D-KG5/LPEDT_revA1_bikeit/LPEDT_revA1_bikeit.pdf

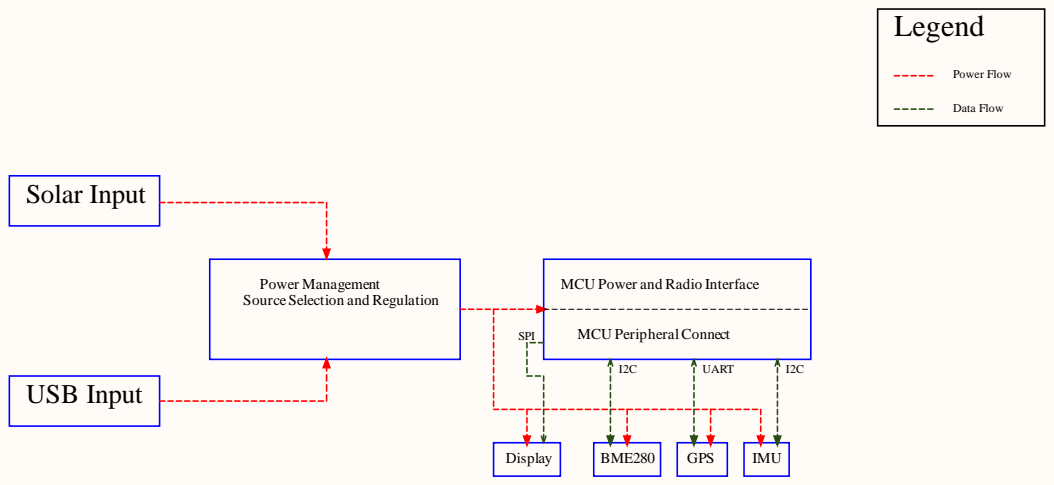
[picture p1: page 1]

MCU Power and Radio Interface

Bike It System Architecture

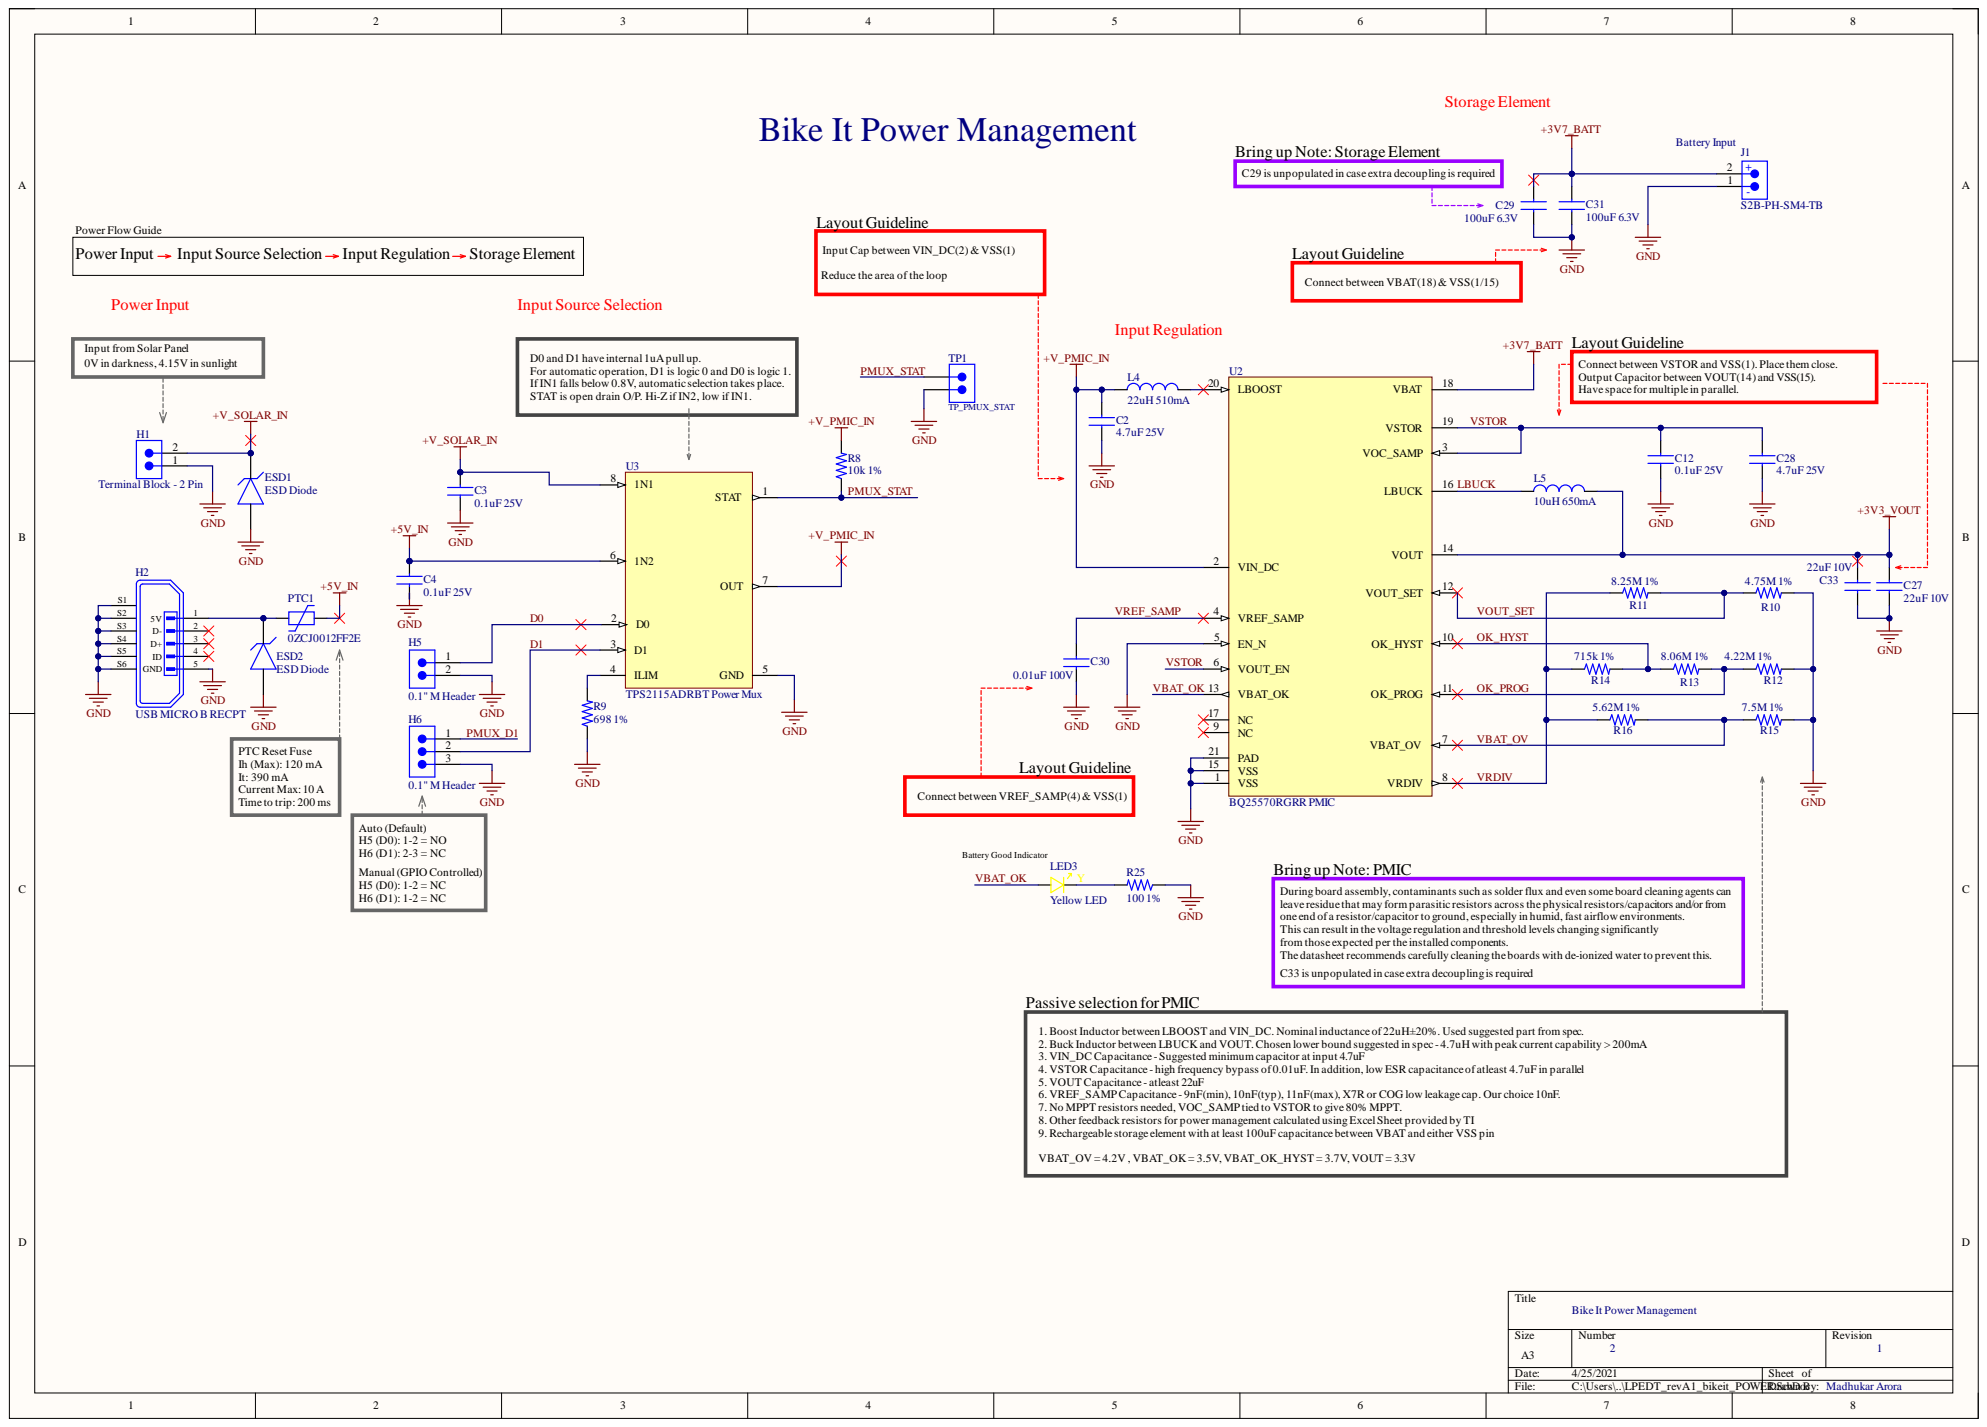
[picture p2: page 2]

Bike It Power Management

Bring up Note: Storage Element

C29 is unpopulated in case extra decoupling isrequired

Input Cap between VIN_DC(2)& VSS(1)

Reduce the area of the loop

Connect between VBAT(18)& VSS(1/15)

Input from Solar Panel

For automatic operation, D1 is logic 0 and D0 is logic 1.
IfIN1 falls below 0.8V, automatic selection takes place.
STAT is open drain O/P. Hi-Z if IN2, low if IN1.

Connect between VSTOR and VSS(1). Place them close.
Output Capacitor between VOUT(14) and VSS(15).
Have space for multiple in parallel.

OK_PROG | R14 R13

PTC Reset Fuse
Ih (Max): 120 mA
Current Max: 10 A
Time to trip: 200 ms

Bring up Note: PMIC

During board assembly, contaminantssuch assolder flux and even some board cleaning agents can
leave residue that may form parasitic resistors acrossthe physicalresistors/capacitors and/or from
one end of a resistor/capacitor to ground, especially in humid, fast airflow environments.
This can result in the voltage regulation and threshold levels changing significantly
from those expected per the installed components.
The datasheet recommends carefully cleaning the boards with de-ionized water to prevent this.
C33 is unpopulated in case extra decoupling isrequired

Passive selection for PMIC

1. Boost Inductor between LBOOST and VIN_DC. Nominal inductance of 22uH±20%. Used suggested part from spec.
2. Buck Inductor between LBUCK and VOUT. Chosen lower bound suggested in spec - 4.7uH with peak current capability > 200mA
3. VIN_DC Capacitance - Suggested minimum capacitor at input 4.7uF
4. VSTOR Capacitance - high frequency bypass of 0.01uF. In addition, low ESR capacitance of atleast 4.7uF in parallel
5. VOUT Capacitance - atleast 22uF
6. VREF_SAMPCapacitance - 9nF(min), 10nF(typ), 11nF(max), X7R or COG low leakage cap. Our choice 10nF.
7. No MPPT resistors needed, VOC_SAMP tied to VSTOR to give 80% MPPT.
8. Other feedback resistorsfor power management calculated usingExcel Sheet provided by TI
9. Rechargeable storage element with at least 100uF capacitance between VBAT and either VSS pin

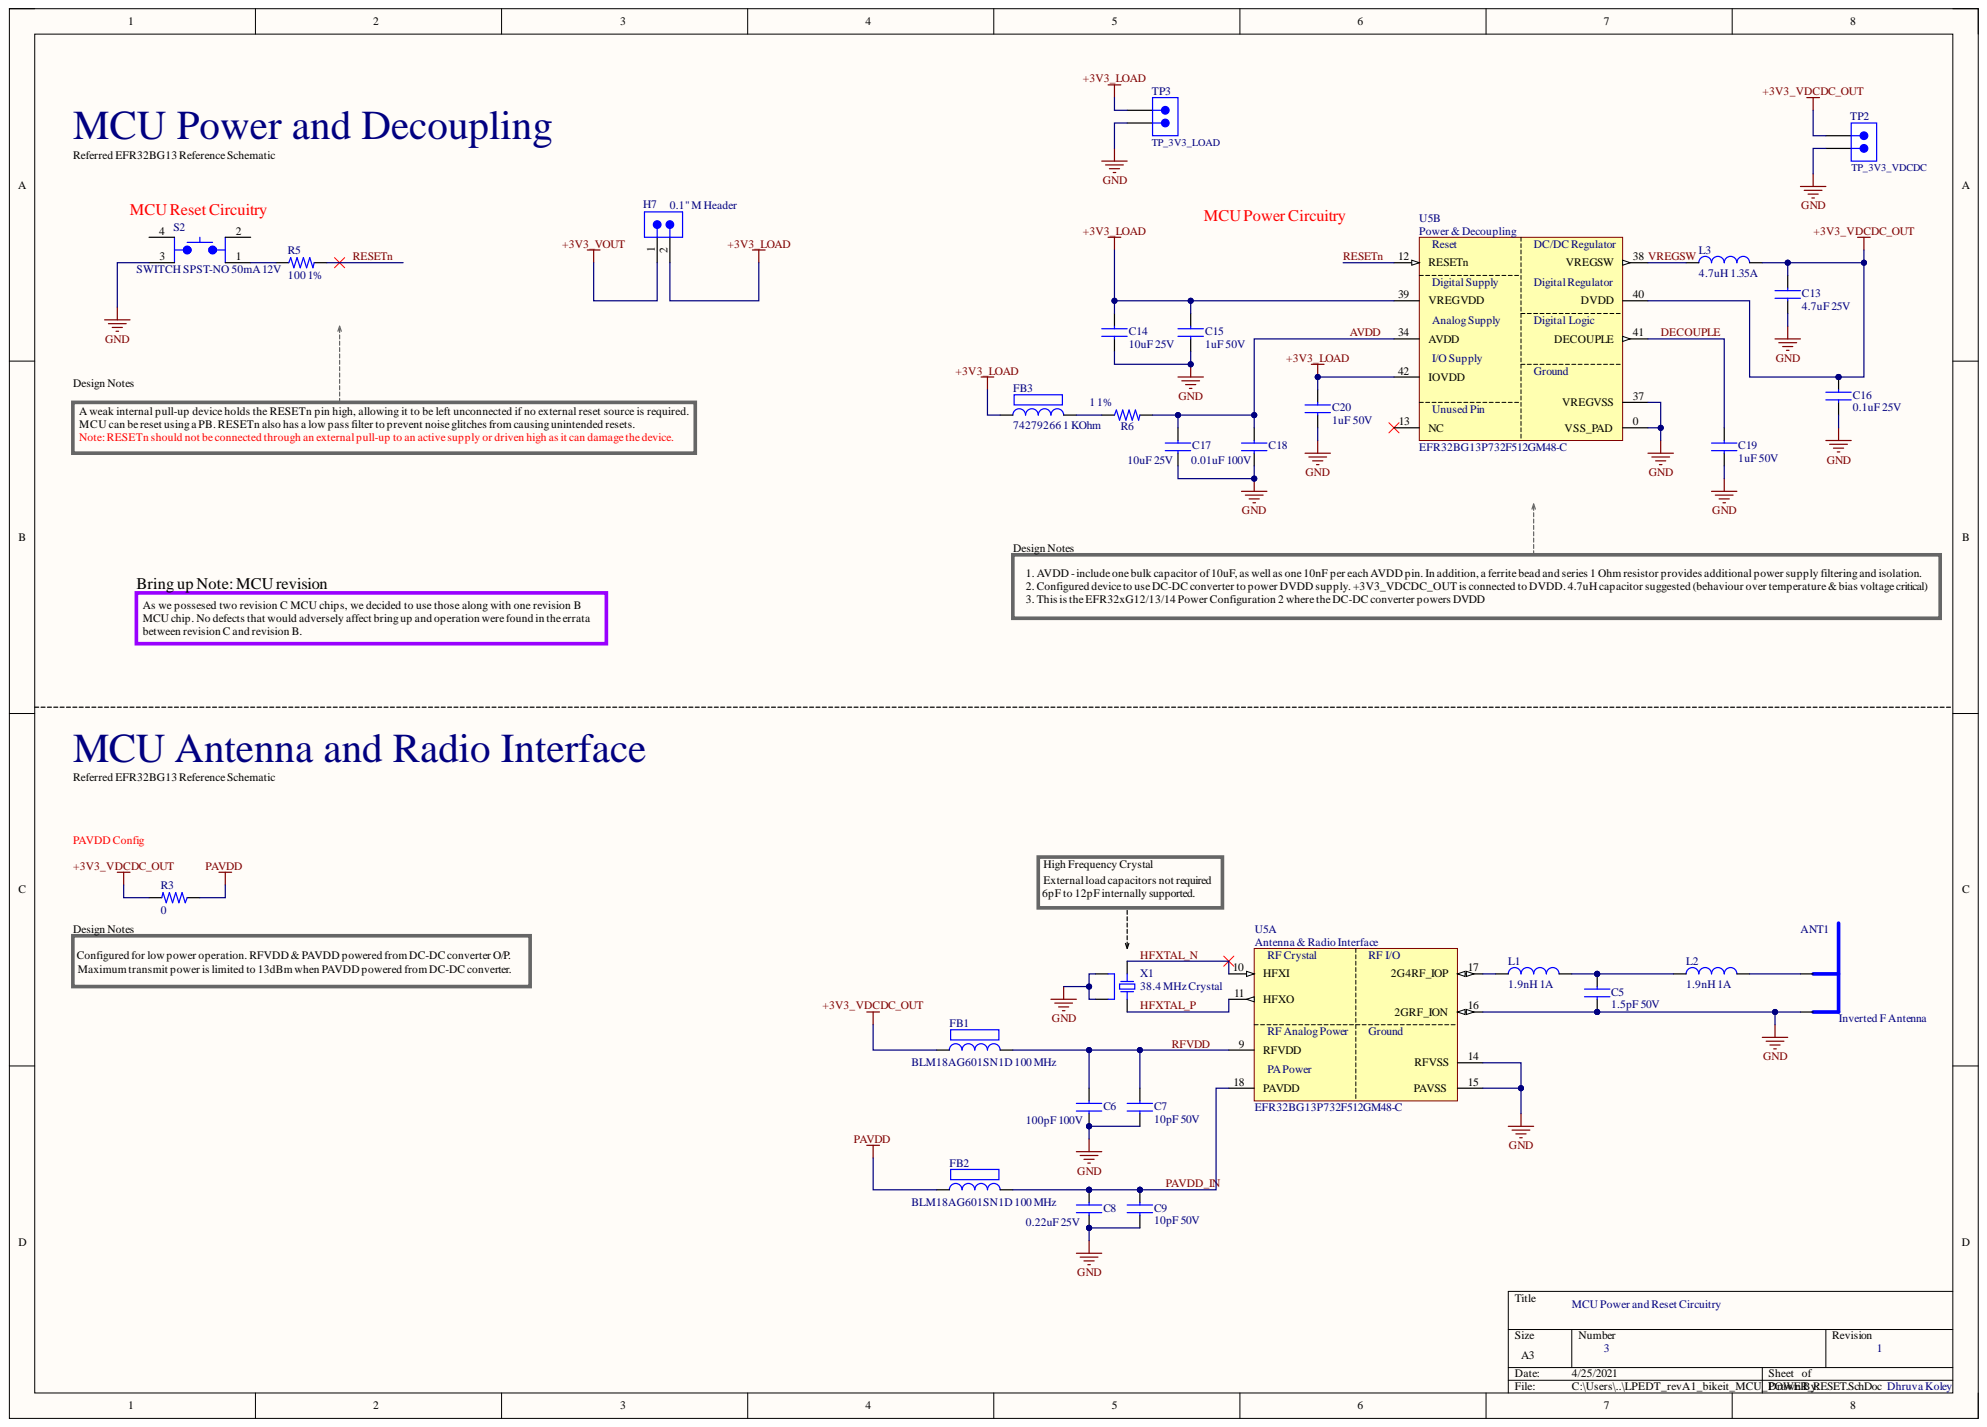
[picture p3: page 3]

MCU Power and Decoupling

A weak internal pull-up device holds the RESETn pin high, allowing it to be left unconnected if no external reset source is required.
MCU can be reset using a PB. RESETn also has a low passfilter to prevent noise glitchesfrom causing unintended resets.
Note:RESETn should not be connected through an external pull-up to an active supply or driven high asit can damage the device.

1. AVDD -include one bulk capacitor of 10uF, as well as one 10nF per each AVDD pin. In addition, a ferrite bead and series 1 Ohm resistor provides additional powersupply filtering and isolation.

3. ThisistheEFR32xG12/13/14 Power Configuration 2 where theDC-DC converter powers DVDD

As we possesed two revision C MCU chips, we decided to use those along with one revision B
MCU chip. No defectsthat would adversely affect bring up and operation were found in the errata
between revision C and revision B.

MCU Antenna and Radio Interface Referred EFR32BG13 ReferenceSchematic

High Frequency Crystal
External load capacitors not required
6pF to 12pF internally supported.

Configured for low power operation. RFVDD & PAVDD powered from DC-DC converter O/P.
Maximum transmit power islimited to 13dBm when PAVDD powered from DC-DC converter.

MCU Power and Reset Circuitry

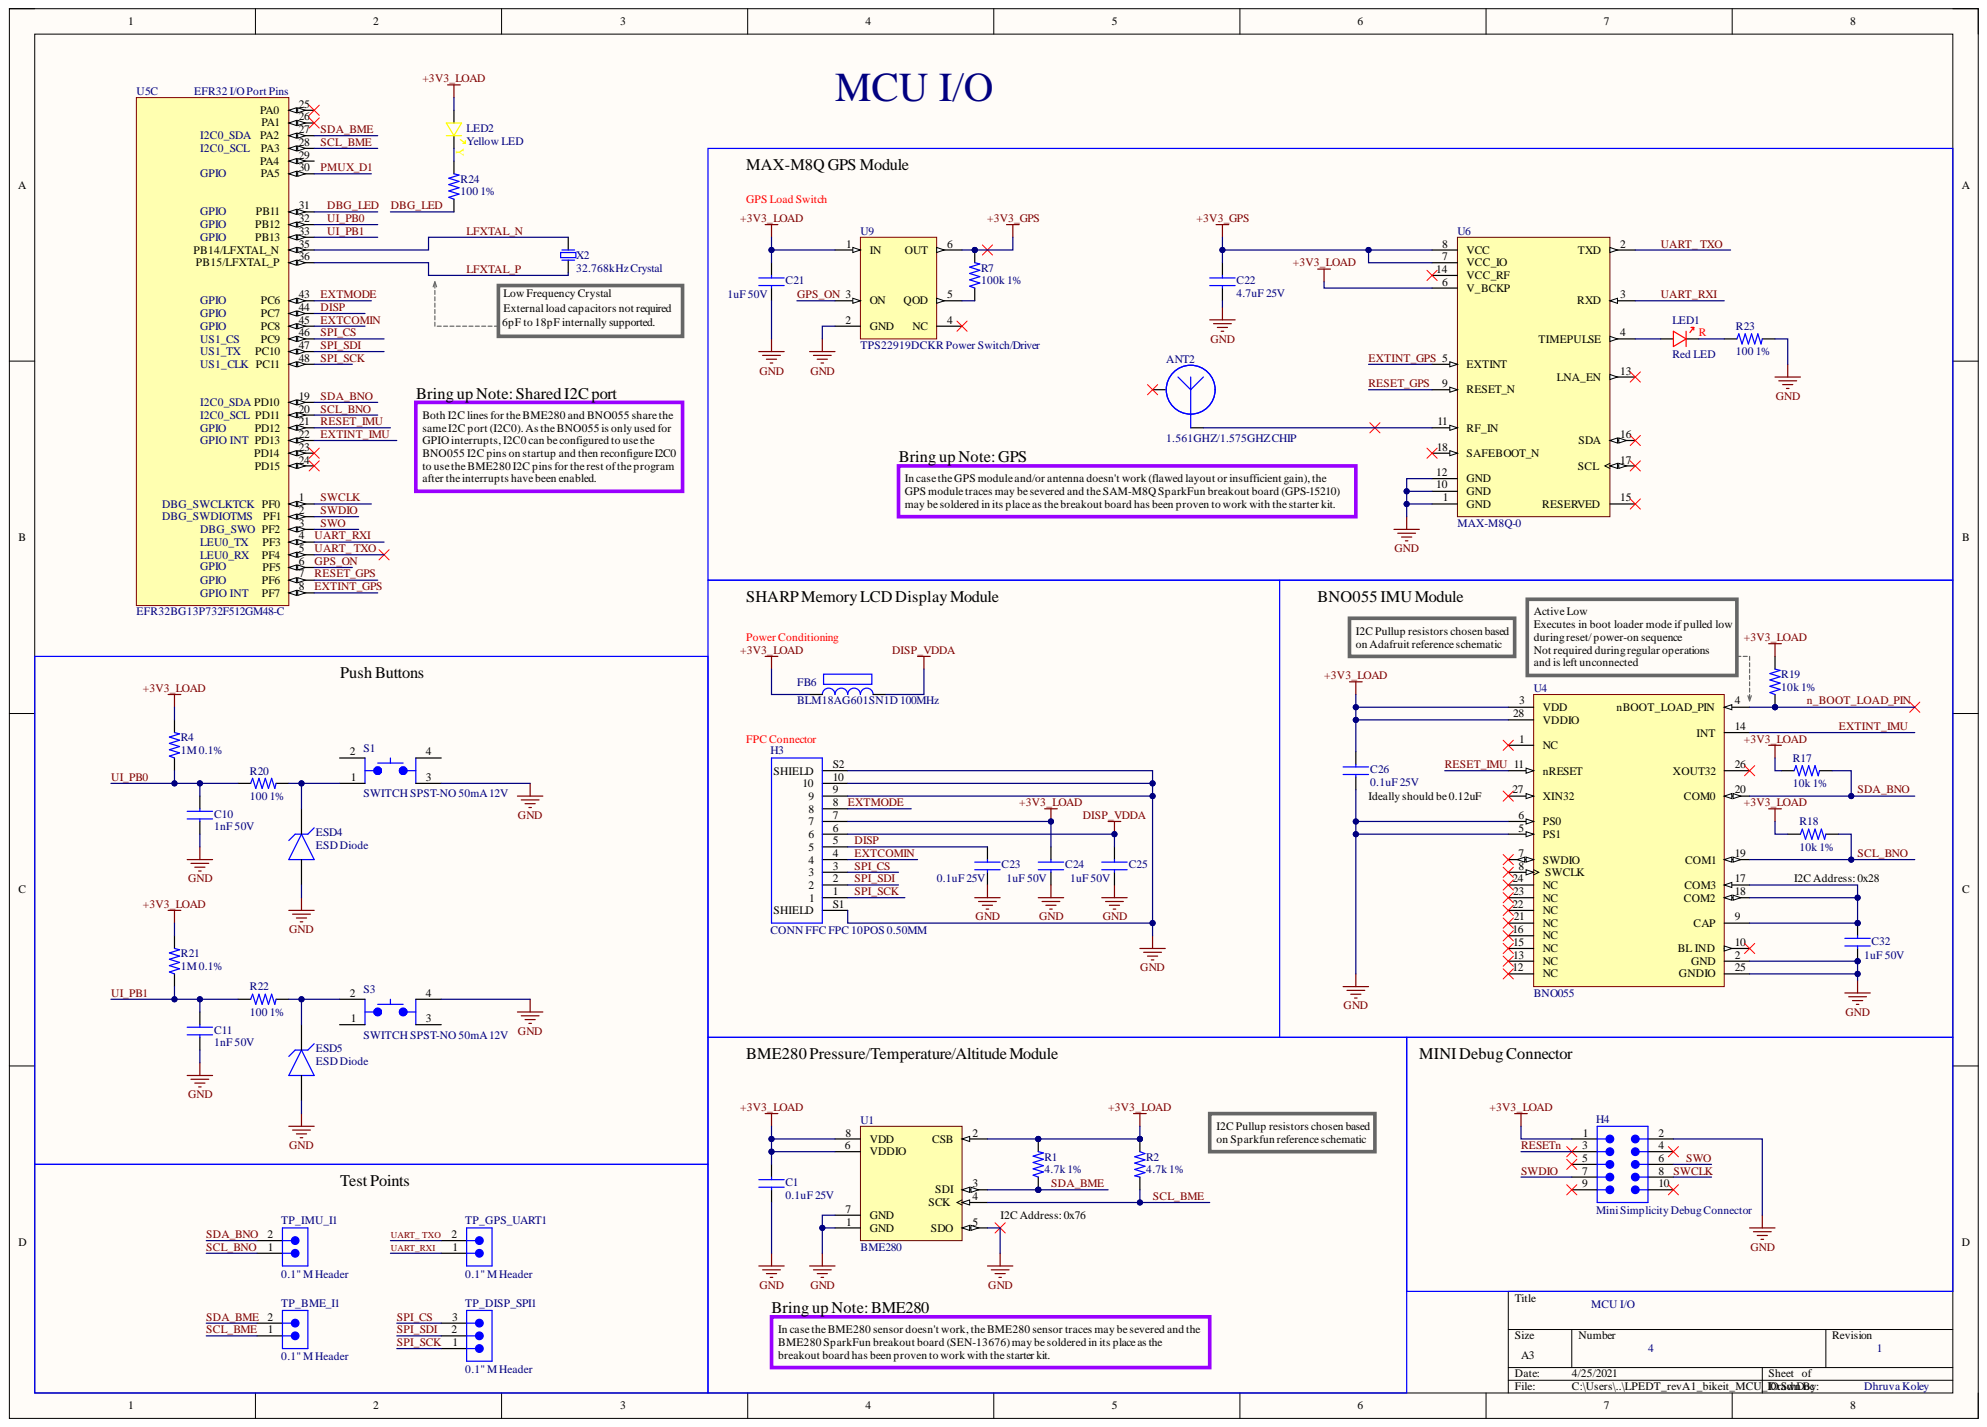
[picture p4: page 4]

Low Frequency Crystal
External load capacitors not required

Bring up Note: Shared I2C port

Both I2C linesfor theBME280 and BNO055 share the
same I2C port (I2C0). AstheBNO055 is only used for
GPIO interrupts, I2C0 can be configured to use the
BNO055 I2C pins on startup and then reconfigure I2C0
to use theBME280 I2C pinsfor the rest ofthe program
after the interrupts have been enabled.

Bring up Note: GPS

In case theGPS module and/or antenna doesn't work (flawed layout or insufficient gain), the
GPS module traces may be severed and theSAM-M8Q SparkFun breakout board (GPS-15210)
may be soldered in its place asthe breakout board has been proven to work with the starter kit.

SHARPMemory LCD Display Module

Active Low
Executes in boot loader mode if pulled low
during reset/ power-on sequence
Not required during regular operations
and isleft unconnected

I2C Pullup resistors chosen based
on Adafruit reference schematic

SWITCH SPST-NO 50mA12V GND

BME280 Pressure/Temperature/Altitude Module

on Sparkfun reference schematic

In case theBME280 sensor doesn't work, theBME280 sensor traces may be severed and the
BME280 SparkFun breakout board (SEN-13676)may be soldered in its place asthe
breakout board has been proven to work with the starter kit.

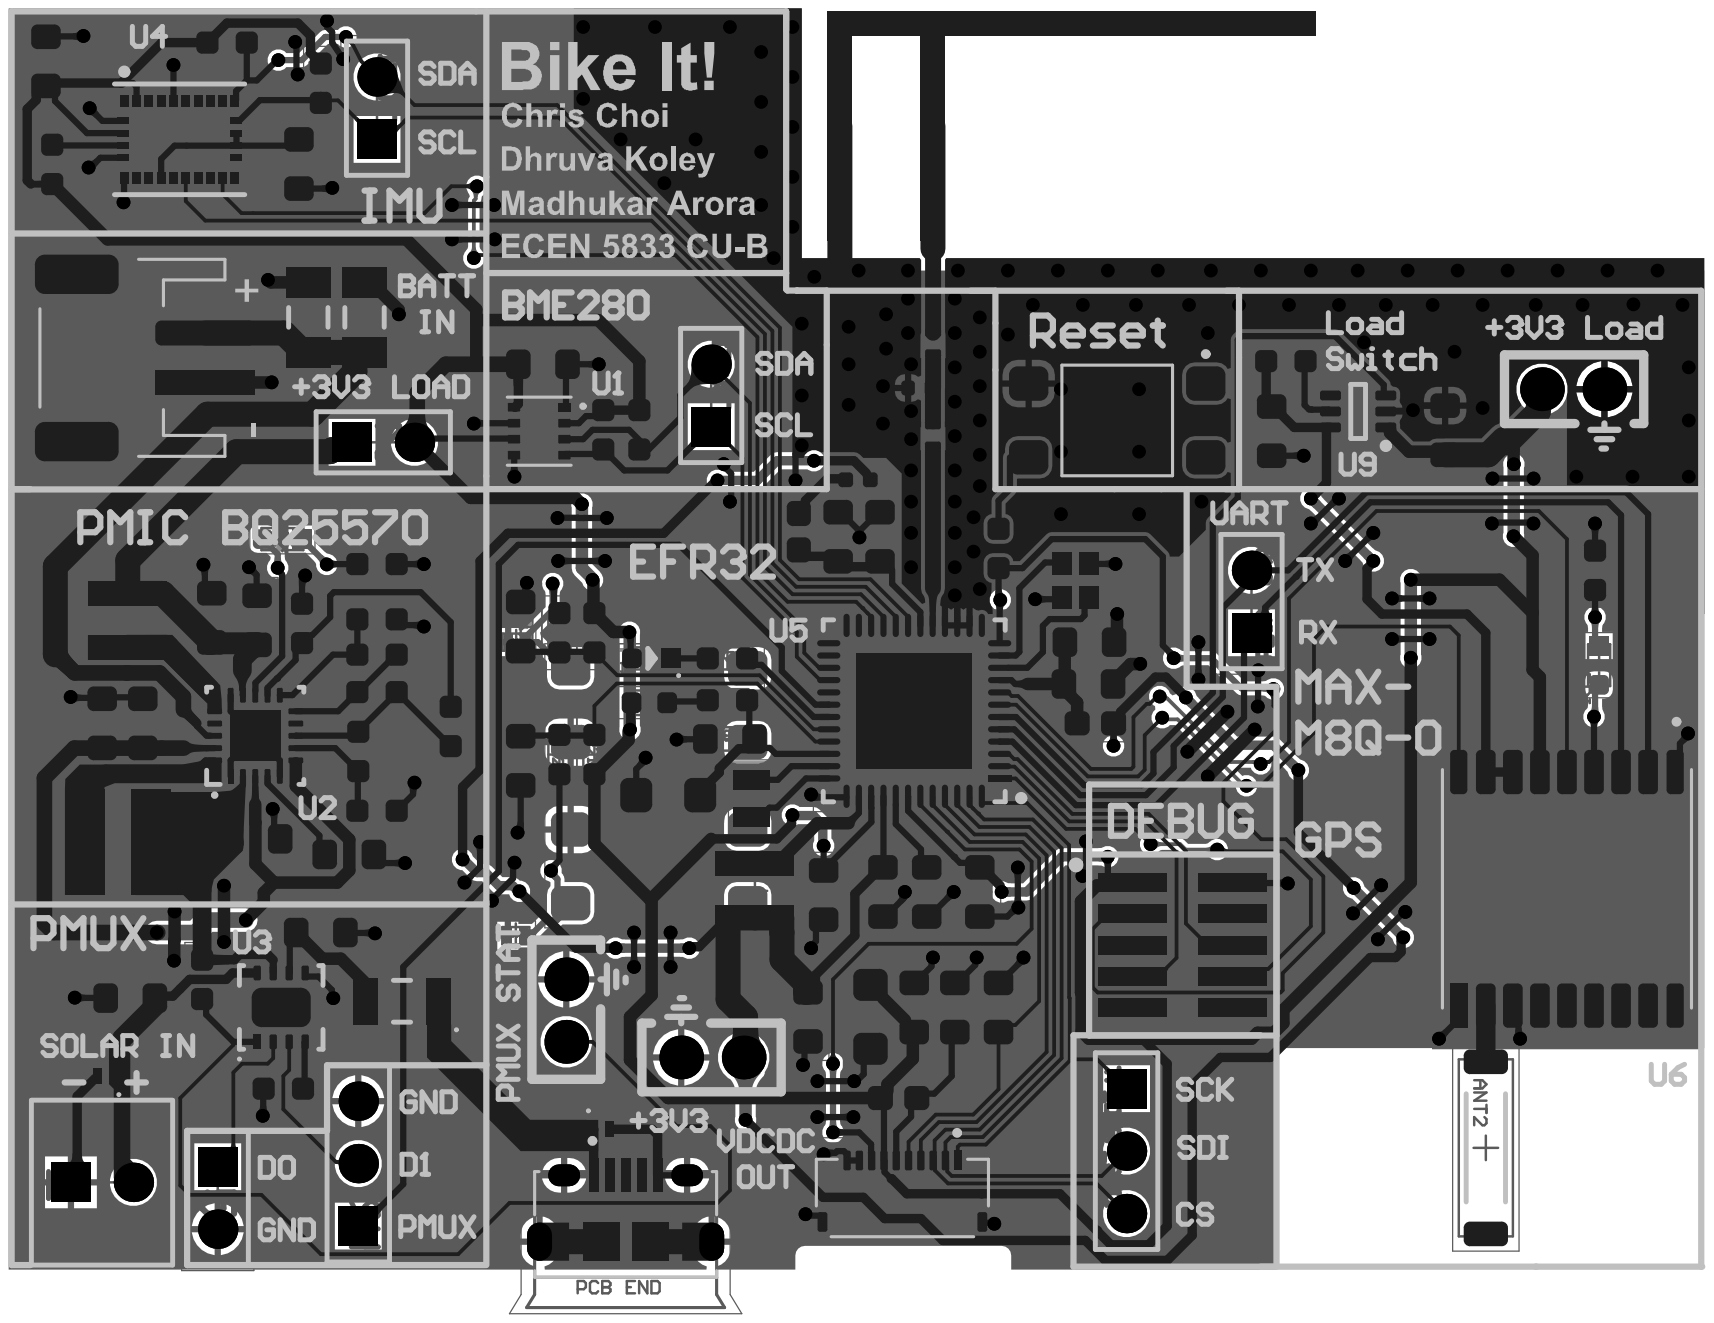
[picture p5: page 5]
