D-KG5/LPEDT_revA1_bikeit/(list of files, drawings)

Other design files:
LPEDT_revA1_BikeIt.PcbDoc
LPEDT_revA1_bikeit.PcbLib
LPEDT_revA1_bikeit.PrjPcb
LPEDT_revA1_bikeit.SchLib
LPEDT_revA1_bikeit_MCU_IO.SchDoc
LPEDT_revA1_bikeit_MCU_POWER_RESET.SchDoc
LPEDT_revA1_bikeit_POWER.SchDoc
LPEDT_revA1_bikeit_rev_01.PcbLib
System Block Diagram.SchDoc
