D-KG5/LPEDT_revA1_bikeit/(commit log)

2021-02-13 updated MAX_M8Q-0 schematic and footprint
    [LPEDT_revA1_bikeit.PcbLib, LPEDT_revA1_bikeit.SchLib]
2021-02-13 updated BME280 schematic and footprint
    [LPEDT_revA1_bikeit.PcbLib, LPEDT_revA1_bikeit.SchLib]
2021-02-13 updated BQ25570RGRR schematic and footprint
    [LPEDT_revA1_bikeit.PcbLib, LPEDT_revA1_bikeit.SchLib]
2021-02-19 updated XCVR_MAX_B8C footprint
    [LPEDT_revA1_bikeit.PcbLib]
2021-02-19 Created MCU footprint and started schematic symbol
    [LPEDT_revA1_bikeit.PcbLib, LPEDT_revA1_bikeit.SchLib]
2021-02-19 Added initial antenna
    [LPEDT_revA1_bikeit.PcbLib, LPEDT_revA1_bikeit.PrjPcb, LPEDT_revA1_bikeit.SchLib]
2021-02-19 added full pin MCU
    [LPEDT_revA1_bikeit.SchLib]
2021-02-20 Chip Antenna Schematic and Footprint Added
    [LPEDT_revA1_bikeit.PcbLib, LPEDT_revA1_bikeit.SchLib]
2021-02-20 Modified chip antenna.
    Still might need correction.
    [LPEDT_revA1_bikeit.PcbLib, LPEDT_revA1_bikeit.SchLib]
2021-02-20 Ferrite Bead schematic symbol created
    used in antenna & radio interface
    [LPEDT_revA1_bikeit.PcbLib, LPEDT_revA1_bikeit.SchLib]
2021-02-20 added display symbol (no footprint)
    [LPEDT_revA1_bikeit.PcbLib, LPEDT_revA1_bikeit.SchLib]
2021-02-21 Added MCU parts and fixed pin config
    [LPEDT_revA1_bikeit.PcbLib, LPEDT_revA1_bikeit.SchLib]
2021-02-21 fixed MCU gpio pins
    [LPEDT_revA1_bikeit.SchLib]
2021-02-21 Pull Up resistor schematic and footprint added, not linked
    [LPEDT_revA1_bikeit.PcbLib, LPEDT_revA1_bikeit.SchLib]
2021-02-21 linked resistor footprint
    [LPEDT_revA1_bikeit.SchLib]
2021-02-21 added LEDs
    [LPEDT_revA1_bikeit.PcbLib, LPEDT_revA1_bikeit.SchLib]
2021-02-21 added micro usb connector
    [LPEDT_revA1_bikeit.PcbLib, LPEDT_revA1_bikeit.SchLib]
2021-02-21 added 0 ohm resistor and button
    a
    [LPEDT_revA1_bikeit.PcbLib, LPEDT_revA1_bikeit.SchLib]
2021-02-21 added FPC Connector
    [LPEDT_revA1_bikeit.PcbLib, LPEDT_revA1_bikeit.PrjPcb, LPEDT_revA1_bikeit.SchLib]
2021-02-21 merged libraries into integrated library. added fpc and TPS IC
    [LPEDT_revA1_bikeit.PcbLib, LPEDT_revA1_bikeit.SchLib]
2021-02-21 added ferrite bead footprint
    [LPEDT_revA1_bikeit.PcbLib, LPEDT_revA1_bikeit.PrjPcb, LPEDT_revA1_bikeit.SchLib]
2021-02-24 Added crystal oscillators, 1kohm ferrite bead, 10uF cap symbols
    [LPEDT_revA1_bikeit.PcbLib, LPEDT_revA1_bikeit.SchLib]
2021-02-24 added push button digikey link
    [LPEDT_revA1_bikeit.SchLib]
2021-02-24 added more misc components
    [LPEDT_revA1_bikeit.SchLib]
2021-02-24 Added GPS schematic draft
    [LPEDT_revA1_bikeit.PrjPcb, LPEDT_revA1_bikeit_GPS.SchDoc]
2021-02-24 Flipped antenna symbol and added missing decoupling cap
    [LPEDT_revA1_bikeit.SchLib]
2021-02-26 Added 0402 and 0603 Ceramic Chip Capacitor Footprint and linked them to the schematic
    [LPEDT_revA1_bikeit.PcbLib, LPEDT_revA1_bikeit.SchLib]
2021-02-26 Added footprint for Ferrite Bead 74279266 Wurth Electronics and Linked to Schematic
    [LPEDT_revA1_bikeit.PcbLib, LPEDT_revA1_bikeit.SchLib]
2021-02-27 added 4.7k pullup resistor for i2c
    [LPEDT_revA1_bikeit.SchLib]
2021-02-27 Added BME280 sensor schematic
    [LPEDT_revA1_bikeit.PrjPcb, LPEDT_revA1_bikeit_GPS.SchDoc, LPEDT_revA1_bikeit_SENSOR.SchDoc]
2021-02-27 cleaning up the ferrite bead schematic to look better
    [LPEDT_revA1_bikeit.PcbLib, LPEDT_revA1_bikeit.SchLib]
2021-02-27 Schematic FB made little cleaner.
    [LPEDT_revA1_bikeit.SchLib]
2021-02-27 minor changes based on review feedback
    [LPEDT_revA1_bikeit.PcbLib, LPEDT_revA1_bikeit.SchLib]
2021-02-27 Fixed inductor and ferrite bead symbol sizes. Fixed connector symbols. Spaced out some chip pins. Added new chip antenna
    [LPEDT_revA1_bikeit.PcbLib, LPEDT_revA1_bikeit.SchLib]
2021-02-27 Minor fixes to schematics
    [LPEDT_revA1_bikeit.PrjPcb, LPEDT_revA1_bikeit_GPS.SchDoc, LPEDT_revA1_bikeit_SENSOR.SchDoc]
2021-02-28 Misc fixes for schematics
    [LPEDT_revA1_bikeit.SchLib, LPEDT_revA1_bikeit_MCU_PINS.SchDoc, LPEDT_revA1_bikeit_MCU_POWER.SchDoc, LPEDT_revA1_bikeit_MCU_RADIO.SchDoc, LPEDT_revA1_bikeit_POWER.SchDoc]
2021-02-28 Added new schematic drafts
    [LPEDT_revA1_bikeit.PrjPcb, LPEDT_revA1_bikeit_GPS.SchDoc, LPEDT_revA1_bikeit_SENSOR.SchDoc]
2021-02-28 Added load switch component
    [LPEDT_revA1_bikeit.SchLib]
2021-02-28 added load switch to the gps schematic
    [LPEDT_revA1_bikeit_GPS.SchDoc]
2021-02-28 modified symbols for schematics
    [LPEDT_revA1_bikeit.SchLib, LPEDT_revA1_bikeit_DISPLAY.SchDoc]
2021-02-28 Added display schematic draft and updated other drafts
    [LPEDT_revA1_bikeit.PrjPcb, LPEDT_revA1_bikeit_GPS.SchDoc, LPEDT_revA1_bikeit_MCU_PINS.SchDoc, LPEDT_revA1_bikeit_MCU_POWER.SchDoc, LPEDT_revA1_bikeit_MCU_RADIO.SchDoc, LPEDT_revA1_bikeit_POWER.SchDoc, LPEDT_revA1_bikeit_SENSOR.SchDoc]
2021-02-28 USB Port added to the Power Management, need to include connections
    [LPEDT_revA1_bikeit_MCU_RADIO.SchDoc, LPEDT_revA1_bikeit_POWER.SchDoc]
2021-02-28 Fixed MCU reset subcircut. Added some mechanical drawings. Fixed some ports
    [LPEDT_revA1_bikeit.PrjPcb, LPEDT_revA1_bikeit_DISPLAY_MECH.SchDoc, LPEDT_revA1_bikeit_GPS.SchDoc, LPEDT_revA1_bikeit_MCU_PINS.SchDoc, LPEDT_revA1_bikeit_POWER.SchDoc, LPEDT_revA1_bikeit_POWER_MECH.SchDoc, LPEDT_revA1_bikeit_SENSOR.SchDoc]
2021-03-01 Added terminal block
    [LPEDT_revA1_bikeit.SchLib]
2021-03-01 updated display and power mechanical drawings
    [LPEDT_revA1_bikeit_DISPLAY.SchDoc, LPEDT_revA1_bikeit_DISPLAY_MECH.SchDoc, LPEDT_revA1_bikeit_POWER.SchDoc, LPEDT_revA1_bikeit_POWER_MECH.SchDoc]
2021-03-01 modified mcu pin part to fir labels
    [LPEDT_revA1_bikeit.SchLib, LPEDT_revA1_bikeit_DEBUG_MECH.SchDoc]
2021-03-01 added debug mechanical schematics and port cleanup
    [LPEDT_revA1_bikeit.PrjPcb, LPEDT_revA1_bikeit_MCU_PINS.SchDoc, LPEDT_revA1_bikeit_MCU_POWER.SchDoc, LPEDT_revA1_bikeit_POWER.SchDoc]
2021-03-02 added test point symbol
    [LPEDT_revA1_bikeit.SchLib, LPEDT_revA1_bikeit_GPS_MECH.SchDoc, LPEDT_revA1_bikeit_SENSOR_MECH.SchDoc]
2021-03-02 added test points to some schematics
    [LPEDT_revA1_bikeit.PrjPcb, LPEDT_revA1_bikeit_DISPLAY_MECH.SchDoc, LPEDT_revA1_bikeit_GPS_MECH.SchDoc, LPEDT_revA1_bikeit_POWER_MECH.SchDoc, LPEDT_revA1_bikeit_SENSOR_MECH.SchDoc]
2021-03-02 Shield Pins Placed together on the USB for easier connections
    [LPEDT_revA1_bikeit.SchLib]
2021-03-02 Shield Pin Name changed
    [LPEDT_revA1_bikeit.PcbLib, LPEDT_revA1_bikeit.SchLib]
2021-03-02 Spacing out Pins on the power Mux
    [LPEDT_revA1_bikeit.SchLib]
2021-03-02 Removing the digikey number from the library
    [LPEDT_revA1_bikeit.SchLib]
2021-03-02 Intermediary commit - cleaning up schematic
    [LPEDT_revA1_bikeit.PrjPcb, LPEDT_revA1_bikeit.SchLib, LPEDT_revA1_bikeit_DEBUG_MECH.SchDoc, LPEDT_revA1_bikeit_DISPLAY.SchDoc, LPEDT_revA1_bikeit_DISPLAY_MECH.SchDoc, LPEDT_revA1_bikeit_GPS.SchDoc, LPEDT_revA1_bikeit_GPS_MECH.SchDoc, LPEDT_revA1_bikeit_MCU_PINS.SchDoc]
2021-03-02 Intermediate commit - cleaning up schematic
    [LPEDT_revA1_bikeit_POWER.SchDoc, LPEDT_revA1_bikeit_POWER_MECH.SchDoc, LPEDT_revA1_bikeit_SENSOR.SchDoc, LPEDT_revA1_bikeit_SENSOR_MECH.SchDoc]
2021-03-03 Fixed error on the MCU - location of pin 37 and 38 swapped
    [LPEDT_revA1_bikeit.SchLib]
2021-03-03 Added 698 Ohm resistor
    [LPEDT_revA1_bikeit.SchLib]
2021-03-03 update QFN50P700x700x90
    [LPEDT_revA1_bikeit.PcbLib]
2021-03-03 updated header footprints
    [LPEDT_revA1_bikeit.PcbLib]
2021-03-03 Added connections for MUX
    [LPEDT_revA1_bikeit_MCU_POWER.SchDoc, LPEDT_revA1_bikeit_POWER.SchDoc, LPEDT_revA1_bikeit_POWER_MECH.SchDoc]
2021-03-03 enlarged CAP 0403 footprint pads
    [LPEDT_revA1_bikeit.PcbLib]
2021-03-03 updated ferrite bead layout
    [LPEDT_revA1_bikeit.PcbLib]
2021-03-03 updated XVR_MAX_M8C top paste
    [LPEDT_revA1_bikeit.PcbLib]
2021-03-03 updated RGR0020A top paste
    [LPEDT_revA1_bikeit.PcbLib]
2021-03-03 Updated XCVR top paste
    [LPEDT_revA1_bikeit.PcbLib]
2021-03-03 updated USB pins
    [LPEDT_revA1_bikeit.SchLib, LPEDT_revA1_bikeit_POWER_MECH.SchDoc]
2021-03-03 updated button and pins
    [LPEDT_revA1_bikeit.SchLib, LPEDT_revA1_bikeit_POWER.SchDoc, LPEDT_revA1_bikeit_POWER_MECH.SchDoc, LPEDT_revA1_bikeit_SENSOR.SchDoc]
2021-03-03 updated pins
    [LPEDT_revA1_bikeit_DISPLAY.SchDoc, LPEDT_revA1_bikeit_GPS.SchDoc, LPEDT_revA1_bikeit_MCU_PINS.SchDoc, LPEDT_revA1_bikeit_MCU_POWER.SchDoc, LPEDT_revA1_bikeit_MCU_RADIO.SchDoc]
2021-03-03 Added PMIC connections and added resistor parts as well
    This is a rough sketch of the whole schematic and would need further refinements.
    [LPEDT_revA1_bikeit.SchLib, LPEDT_revA1_bikeit_MCU_PINS.SchDoc, LPEDT_revA1_bikeit_MCU_POWER.SchDoc, LPEDT_revA1_bikeit_MCU_RADIO.SchDoc, LPEDT_revA1_bikeit_POWER.SchDoc, LPEDT_revA1_bikeit_POWER_MECH.SchDoc]
2021-03-03 modified mcu power pin
    [LPEDT_revA1_bikeit.SchLib]
2021-03-03 final schematic draft cleanup for review
    [LPEDT_revA1_bikeit.PrjPcb, LPEDT_revA1_bikeit_DEBUG_MECH.SchDoc, LPEDT_revA1_bikeit_DISPLAY.SchDoc, LPEDT_revA1_bikeit_DISPLAY_MECH.SchDoc, LPEDT_revA1_bikeit_GPS.SchDoc, LPEDT_revA1_bikeit_GPS_MECH.SchDoc, LPEDT_revA1_bikeit_MCU_PINS.SchDoc, LPEDT_revA1_bikeit_MCU_POWER.SchDoc]
2021-03-03 Changed Inverted F Antenna to net tie no bom and display to graphical
    [LPEDT_revA1_bikeit.SchLib]
2021-03-03 changed power port names
    [LPEDT_revA1_bikeit.PrjPcb, LPEDT_revA1_bikeit_DEBUG_MECH.SchDoc, LPEDT_revA1_bikeit_DISPLAY.SchDoc, LPEDT_revA1_bikeit_GPS.SchDoc, LPEDT_revA1_bikeit_MCU_POWER.SchDoc, LPEDT_revA1_bikeit_MCU_RADIO.SchDoc, LPEDT_revA1_bikeit_POWER.SchDoc, LPEDT_revA1_bikeit_POWER_MECH.SchDoc]
2021-03-04 Resistors naming convention cleaned up.
    values above 10 Ohm should not have Ohm in them.
    k should be small case.
    [LPEDT_revA1_bikeit.SchLib]
2021-03-04 Cleaned up Power Management sheet
    [LPEDT_revA1_bikeit.PrjPcb, LPEDT_revA1_bikeit.SchLib, LPEDT_revA1_bikeit_POWER.SchDoc]
2021-03-05 Fixed display schematic ports
    [LPEDT_revA1_bikeit_DISPLAY.SchDoc, LPEDT_revA1_bikeit_DISPLAY_MECH.SchDoc, LPEDT_revA1_bikeit_MCU_PINS.SchDoc]
2021-03-05 removed DISP_VDD net name
    [LPEDT_revA1_bikeit_DEBUG_MECH.SchDoc, LPEDT_revA1_bikeit_DISPLAY.SchDoc, LPEDT_revA1_bikeit_DISPLAY_MECH.SchDoc]
2021-03-05 added debug gpio test points
    [LPEDT_revA1_bikeit.PrjPcb, LPEDT_revA1_bikeit_DEBUG_MECH.SchDoc, LPEDT_revA1_bikeit_MCU_PINS.SchDoc]
2021-03-05 Cleaned up power management schematic
    [LPEDT_revA1_bikeit_POWER.SchDoc]
2021-03-05 replaced 1 ohm resistor footprint link
    [LPEDT_revA1_bikeit.SchLib]
2021-03-05 component update
    [LPEDT_revA1_bikeit_GPS_MECH.SchDoc, LPEDT_revA1_bikeit_MCU_POWER.SchDoc]
2021-03-05 fixed test point port directions and removed unnecessary no ERC marks
    [LPEDT_revA1_bikeit_DISPLAY.SchDoc, LPEDT_revA1_bikeit_DISPLAY_MECH.SchDoc, LPEDT_revA1_bikeit_MCU_PINS.SchDoc, LPEDT_revA1_bikeit_MCU_POWER.SchDoc, LPEDT_revA1_bikeit_SENSOR_MECH.SchDoc]
2021-03-05 fixed gps test point port directions
    [LPEDT_revA1_bikeit_GPS_MECH.SchDoc]
2021-03-05 Storage Capacitor Added
    [LPEDT_revA1_bikeit_POWER.SchDoc]
2021-03-05 Added layout guidelines, merging mechanical and power management circuitry
    [LPEDT_revA1_bikeit.PrjPcb, LPEDT_revA1_bikeit_POWER.SchDoc, LPEDT_revA1_bikeit_POWER_MECH.SchDoc, LPEDT_revA1_bikeit_SENSOR.SchDoc]
2021-03-05 Removing warnings from the power management sheet
    [LPEDT_revA1_bikeit_POWER.SchDoc]
2021-03-05 Partial commit - modifying the MCU power circuit and verifying configurations from the spec.
    [LPEDT_revA1_bikeit_MCU_POWER.SchDoc, LPEDT_revA1_bikeit_POWER.SchDoc]
2021-03-06 MCU Power and Radio Interface - cleaned up
    High Frequency clock moved closer to the ckt.
    [LPEDT_revA1_bikeit_MCU_PINS.SchDoc, LPEDT_revA1_bikeit_MCU_POWER.SchDoc, LPEDT_revA1_bikeit_MCU_RADIO.SchDoc, LPEDT_revA1_bikeit_POWER.SchDoc]
2021-03-06 Correcting PB15 to LFXTAL_P
    [LPEDT_revA1_bikeit.SchLib]
2021-03-06 Merged power and reset circuitry in one schematic sheet
    [LPEDT_revA1_bikeit.PrjPcb, LPEDT_revA1_bikeit_GPS.SchDoc, LPEDT_revA1_bikeit_MCU_PINS.SchDoc, LPEDT_revA1_bikeit_MCU_POWER.SchDoc, LPEDT_revA1_bikeit_MCU_POWER_RESET.SchDoc, LPEDT_revA1_bikeit_MCU_RADIO.SchDoc]
2021-03-06 Merged all schematic documents into modules, need to add ESD protection
    [LPEDT_revA1_bikeit_DEBUG_MECH.SchDoc, LPEDT_revA1_bikeit_DISPLAY.SchDoc, LPEDT_revA1_bikeit_DISPLAY_MECH.SchDoc, LPEDT_revA1_bikeit_GPS.SchDoc, LPEDT_revA1_bikeit_GPS_MECH.SchDoc, LPEDT_revA1_bikeit_MCU_IO.SchDoc, LPEDT_revA1_bikeit_MCU_PINS.SchDoc, LPEDT_revA1_bikeit_MCU_POWER_RESET.SchDoc]
2021-03-06 Removed error, warnings are still there.
    [LPEDT_revA1_bikeit.PrjPcb, LPEDT_revA1_bikeit_MCU_IO.SchDoc, LPEDT_revA1_bikeit_MCU_POWER_RESET.SchDoc, LPEDT_revA1_bikeit_POWER.SchDoc]
2021-03-06 4 way junction on power sheet -removed
    [LPEDT_revA1_bikeit_POWER.SchDoc]
2021-03-07 added voltage divider resistors and BNO055 components
    [LPEDT_revA1_bikeit.PcbLib, LPEDT_revA1_bikeit.SchLib]
2021-03-07 Including some netlabel corrections and the system architecture
    [LPEDT_revA1_bikeit.PrjPcb, LPEDT_revA1_bikeit_MCU_IO.SchDoc, LPEDT_revA1_bikeit_MCU_POWER_RESET.SchDoc, LPEDT_revA1_bikeit_POWER.SchDoc, System Block Diagram.SchDoc]
2021-03-07 added 100 ohm resistor
    [LPEDT_revA1_bikeit.SchLib]
2021-03-07 Some review fixes PMUX_STAT wired to look like a pullup. Feedback resisistors and VREF_SAMP and LBUCK have netlabels Replace bulk cap on VOUT. Have multiple 22uF caps instead No ERC markers on PMIC f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
    [LPEDT_revA1_bikeit_MCU_IO.SchDoc, LPEDT_revA1_bikeit_MCU_POWER_RESET.SchDoc, LPEDT_revA1_bikeit_POWER.SchDoc]
2021-03-07 added 10 uH inductor and removed redundant components
    [LPEDT_revA1_bikeit.SchLib]
2021-03-07 More review changes Used 10uH buck inductor for LBUCK instead GPS_ON pin on the left FB @ frequency instead of impedence Swapped out MCU model to rev C
    [LPEDT_revA1_bikeit.PrjPcb, LPEDT_revA1_bikeit_MCU_IO.SchDoc, LPEDT_revA1_bikeit_MCU_POWER_RESET.SchDoc, LPEDT_revA1_bikeit_POWER.SchDoc]
2021-03-08 changed BNO055 pin placements
    [LPEDT_revA1_bikeit.SchLib]
2021-03-08 added BNO055 subcircuit
    [LPEDT_revA1_bikeit.PrjPcb, LPEDT_revA1_bikeit_MCU_IO.SchDoc, LPEDT_revA1_bikeit_POWER.SchDoc]
2021-03-08 added coin cell holder (verify footprint) removed voltage divider resistors
    [LPEDT_revA1_bikeit.PcbLib, LPEDT_revA1_bikeit.SchLib]
2021-03-08 fixed BNO055 pull up resistors and added design notes replaced voltage divider on V_BCKP pin with coin cell
    [LPEDT_revA1_bikeit_MCU_IO.SchDoc, LPEDT_revA1_bikeit_MCU_POWER_RESET.SchDoc]
2021-03-08 added some verified wuerth footprints still requires additional verification
    [LPEDT_revA1_bikeit.PcbLib, LPEDT_revA1_bikeit.SchLib]
2021-03-08 fixed annotations
    [LPEDT_revA1_bikeit.PrjPcb, LPEDT_revA1_bikeit_MCU_IO.SchDoc]
2021-03-11 Added footprint of the load switch
    [LPEDT_revA1_bikeit.PcbLib, LPEDT_revA1_bikeit.SchLib]
2021-03-11 Added Johanson Chip Antenna
    [LPEDT_revA1_bikeit.PcbLib, LPEDT_revA1_bikeit.SchLib]
2021-03-11 Added Inductor 0402 part footprint
    [LPEDT_revA1_bikeit.PcbLib, LPEDT_revA1_bikeit.SchLib]
2021-03-15 initial spread of comonents
    [LPEDT_revA1_bikeit.PrjPcb, LPEDT_revA1_bikeit_MCU_IO.SchDoc, LPEDT_revA1_bikeit_rev_01.PcbLib]
2021-03-15 replaced decoupling cap subcircuit for mcu power with 0 ohm jumper and added power mux jumper circuit
    [LPEDT_revA1_bikeit.PrjPcb, LPEDT_revA1_bikeit_MCU_IO.SchDoc, LPEDT_revA1_bikeit_MCU_POWER_RESET.SchDoc, LPEDT_revA1_bikeit_POWER.SchDoc]
2021-03-15 added footprints from library to schematics
    [LPEDT_revA1_bikeit.PrjPcb, LPEDT_revA1_bikeit_MCU_IO.SchDoc, LPEDT_revA1_bikeit_MCU_POWER_RESET.SchDoc, LPEDT_revA1_bikeit_POWER.SchDoc]
2021-03-15 reset origin
    [LPEDT_revA1_bikeit_rev_01.PcbLib]
2021-03-15 added ESD diode
    [LPEDT_revA1_bikeit.PcbLib, LPEDT_revA1_bikeit.SchLib]
2021-03-15 added ESD diodes to usb and solar in
    [LPEDT_revA1_bikeit_POWER.SchDoc]
2021-03-15 added ESD diode to coin cell holder
    [LPEDT_revA1_bikeit_MCU_IO.SchDoc]
2021-03-16 Added footprint 32.768 kHz crystal
    [LPEDT_revA1_bikeit.PcbLib, LPEDT_revA1_bikeit.SchLib, LPEDT_revA1_bikeit_POWER.SchDoc]
2021-03-16 Adding boundary to the 2 pin crystal
    [LPEDT_revA1_bikeit.PcbLib]
2021-03-16 38.4Mhz crystal footprint added
    [LPEDT_revA1_bikeit.PcbLib, LPEDT_revA1_bikeit.SchLib]
2021-03-16 minor edits - adding .Designator where not present
    [LPEDT_revA1_bikeit.PcbLib]
2021-03-16 renamed footprints to be more readable
    [LPEDT_revA1_bikeit.PcbLib, LPEDT_revA1_bikeit.SchLib]
2021-03-16 updated footprints in schematics
    [LPEDT_revA1_bikeit.PrjPcb, LPEDT_revA1_bikeit_MCU_IO.SchDoc, LPEDT_revA1_bikeit_MCU_POWER_RESET.SchDoc, LPEDT_revA1_bikeit_POWER.SchDoc]
2021-03-16 Added ESD SOD882 Package footprint
    [LPEDT_revA1_bikeit.PcbLib, LPEDT_revA1_bikeit.SchLib]
2021-03-17 Tried updating the Schematic with new footprint. Not sure it worked correctly
    [LPEDT_revA1_bikeit.PcbLib, LPEDT_revA1_bikeit.PrjPcb, LPEDT_revA1_bikeit_POWER.SchDoc]
2021-03-17 fixed esd diode footprint update
    [LPEDT_revA1_bikeit.PcbLib]
2021-03-17 fixed esd diodes in schematic
    [LPEDT_revA1_bikeit.PrjPcb, LPEDT_revA1_bikeit_MCU_IO.SchDoc, LPEDT_revA1_bikeit_POWER.SchDoc]
2021-03-17 added ftsh connector footprint
    [LPEDT_revA1_bikeit.PcbLib]
2021-03-17 attached footprint to part
    [LPEDT_revA1_bikeit.SchLib]
2021-03-17 updated debug connector part with footprint
    [LPEDT_revA1_bikeit.PrjPcb, LPEDT_revA1_bikeit_MCU_IO.SchDoc]
2021-03-17 Fixed the voltage divider network for PMIC
    [LPEDT_revA1_bikeit_POWER.SchDoc]
2021-03-17 adding pin 1 indicator to mini debug connector
    [LPEDT_revA1_bikeit.PcbLib]
2021-03-17 updated terminal plock footprint
    [LPEDT_revA1_bikeit.PcbLib, LPEDT_revA1_bikeit.SchLib]
2021-03-17 updated terminal block footprint
    [LPEDT_revA1_bikeit_POWER.SchDoc]
2021-03-17 Added footprints for Inverted F antenna and TP
    [LPEDT_revA1_bikeit.PcbLib, LPEDT_revA1_bikeit.SchLib, LPEDT_revA1_bikeit_rev_01.PcbDoc]
2021-03-17 Brought in modified footprint of the F antenna
    [LPEDT_revA1_bikeit.PrjPcb, LPEDT_revA1_bikeit_MCU_POWER_RESET.SchDoc]
2021-03-17 Added Jumper to load circuitry
    [LPEDT_revA1_bikeit_MCU_IO.SchDoc, LPEDT_revA1_bikeit_MCU_POWER_RESET.SchDoc]
2021-03-17 power port modified
    [LPEDT_revA1_bikeit_MCU_IO.SchDoc, LPEDT_revA1_bikeit_MCU_POWER_RESET.SchDoc]
2021-03-17 Added test points and push buttons.
    [LPEDT_revA1_bikeit.PcbLib, LPEDT_revA1_bikeit.SchLib, LPEDT_revA1_bikeit_MCU_IO.SchDoc, LPEDT_revA1_bikeit_MCU_POWER_RESET.SchDoc, LPEDT_revA1_bikeit_POWER.SchDoc]
2021-03-17 LED added
    [LPEDT_revA1_bikeit_MCU_IO.SchDoc, LPEDT_revA1_bikeit_POWER.SchDoc]
2021-03-17 battery good indicator fixed
    [LPEDT_revA1_bikeit_MCU_IO.SchDoc, LPEDT_revA1_bikeit_POWER.SchDoc]
2021-03-17 fixed test point pin naming scheme
    [LPEDT_revA1_bikeit.SchLib, LPEDT_revA1_bikeit_MCU_IO.SchDoc]
2021-03-17 minor changes
    [LPEDT_revA1_bikeit.PrjPcb, LPEDT_revA1_bikeit_MCU_IO.SchDoc]
2021-03-17 test point names - corrected
    [LPEDT_revA1_bikeit_MCU_IO.SchDoc]
2021-03-18 clean slate - PCB document
    [LPEDT_revA1_BikeIt.PcbDoc, LPEDT_revA1_bikeit.PrjPcb, LPEDT_revA1_bikeit_MCU_IO.SchDoc, LPEDT_revA1_bikeit_POWER.SchDoc, LPEDT_revA1_bikeit_rev_01.PcbDoc]
2021-03-18 Intermediate commit - placement started
    [LPEDT_revA1_BikeIt.PcbDoc, LPEDT_revA1_bikeit_POWER.SchDoc]
2021-03-18 placement of input and regulation done
    [LPEDT_revA1_bikeit.PrjPcb]
2021-03-19 rearranged communications pins to improve layout
    [LPEDT_revA1_bikeit_MCU_IO.SchDoc]
2021-03-19 fixed gps footprint pads
    [LPEDT_revA1_bikeit.PcbLib, LPEDT_revA1_bikeit.SchLib]
2021-03-19 flipped jst and updated gps footprint pads
    [LPEDT_revA1_bikeit_MCU_IO.SchDoc]
2021-03-19 removed coinc cell and moved microusb
    [LPEDT_revA1_bikeit_MCU_IO.SchDoc]
2021-03-19 Power Input decluttered
2021-03-19 mcu i/o intermediate
    gps done, others remaining
    [LPEDT_revA1_bikeit_MCU_IO.SchDoc, LPEDT_revA1_bikeit_MCU_POWER_RESET.SchDoc]
2021-03-20 preliminary display placement
    [LPEDT_revA1_bikeit_MCU_IO.SchDoc]
2021-03-20 fixed bme280 pads
    [LPEDT_revA1_bikeit.PcbLib]
2021-03-20 BME 280 placement done - new footprint
2021-03-20 layout done, tp and pb remain
    [LPEDT_revA1_bikeit_MCU_IO.SchDoc]
2021-03-22 added ptc fuse component and footprint 0ZCJ0012FF2E
    [LPEDT_revA1_bikeit.PcbLib, LPEDT_revA1_bikeit.SchLib]
2021-03-22 added ptc fuse to schematic
    [LPEDT_revA1_bikeit.PrjPcb, LPEDT_revA1_bikeit_POWER.SchDoc]
2021-03-22 added ptc fuse to layout
    [LPEDT_revA1_bikeit_POWER.SchDoc]
2021-03-22 shortened board length
    [LPEDT_revA1_bikeit.PrjPcb]
2021-03-22 added note to ptc fuse and added output file job
    [LPEDT_revA1_bikeit.PrjPcb, LPEDT_revA1_bikeit_POWER.SchDoc]
2021-03-23 update test points
    [LPEDT_revA1_bikeit_MCU_IO.SchDoc, LPEDT_revA1_bikeit_POWER.SchDoc]
2021-03-23 update antenna footprint updated placement
    [LPEDT_revA1_bikeit.PcbLib, LPEDT_revA1_bikeit.PrjPcb, LPEDT_revA1_bikeit.SchLib]
2021-03-24 debug connector
    [LPEDT_revA1_bikeit.PcbLib]
2021-03-24 update placements
    [LPEDT_revA1_bikeit.PcbLib, LPEDT_revA1_bikeit_MCU_IO.SchDoc]
2021-03-24 update silkscreen
2021-03-29 updated test points to no 3d pins
    [LPEDT_revA1_bikeit.SchLib, LPEDT_revA1_bikeit_MCU_IO.SchDoc, LPEDT_revA1_bikeit_MCU_POWER_RESET.SchDoc]
2021-03-29 updated headers
    [LPEDT_revA1_bikeit_MCU_IO.SchDoc]
2021-03-29 updated 100uF and 22uF caps
    [LPEDT_revA1_bikeit.PcbLib, LPEDT_revA1_bikeit.SchLib, LPEDT_revA1_bikeit_MCU_IO.SchDoc, LPEDT_revA1_bikeit_MCU_POWER_RESET.SchDoc, LPEDT_revA1_bikeit_POWER.SchDoc]
2021-03-29 start tracing
    [LPEDT_revA1_bikeit_POWER.SchDoc]
2021-03-29 PMUX traced
2021-03-29 antenna trace
2021-03-29 corrected bme280 silkscreen label
2021-03-29 added ground pour
2021-03-29 finished initial board
2021-03-29 added cutout for display cable
2021-03-29 removed top paste from antenna
    [LPEDT_revA1_bikeit.PcbLib]
2021-03-29 added new supplier links to components
    [LPEDT_revA1_bikeit.SchLib]
2021-03-29 confirmed supplier links
    [LPEDT_revA1_bikeit.SchLib]
2021-03-29 updated schematics and pcb with new supplier links
    [LPEDT_revA1_bikeit.PrjPcb, LPEDT_revA1_bikeit_MCU_IO.SchDoc, LPEDT_revA1_bikeit_MCU_POWER_RESET.SchDoc, LPEDT_revA1_bikeit_POWER.SchDoc]
2021-03-30 replaced supplier links to digikey when able
    [LPEDT_revA1_bikeit.SchLib]
2021-03-31 added new jst connector
    [LPEDT_revA1_bikeit.PcbLib, LPEDT_revA1_bikeit.SchLib]
2021-04-08 fixed unnamed ground stitch fixed 3v3load power trace
2021-04-08 rearranged 3v7batt trace
2021-04-08 IMU power correction
2021-04-09 rerouted 3v3load trace
2021-04-09 update buttons
    [LPEDT_revA1_bikeit_MCU_IO.SchDoc, LPEDT_revA1_bikeit_MCU_POWER_RESET.SchDoc]
2021-04-09 updated mcu paste and moved antenna
    [LPEDT_revA1_bikeit.PcbLib]
2021-04-09 updated MCU vias and paste
    [LPEDT_revA1_bikeit.PcbLib]
2021-04-24 Misc label cleanup
    [LPEDT_revA1_bikeit_MCU_IO.SchDoc, LPEDT_revA1_bikeit_MCU_POWER_RESET.SchDoc, LPEDT_revA1_bikeit_POWER.SchDoc]
2021-04-26 added bring up notes
    [LPEDT_revA1_bikeit_MCU_IO.SchDoc, LPEDT_revA1_bikeit_MCU_POWER_RESET.SchDoc, LPEDT_revA1_bikeit_POWER.SchDoc, System Block Diagram.SchDoc]
